EbrSiami/OpenRC-STM32/docs/README_RU.md

# OpenRC-STM32










**Открытая система радиоуправления на базе STM32** — прошивка передатчика, прошивка приемника и наземная станция для ПК для работы в симуляторе. Всё, что необходимо для создания полностью кастомного канала радиоуправления с нуля.

> 📖 **README на других языках:** [English](../README.md) · [Фарси (فارسی)](README_FA.md)

---

## Содержимое репозитория

| Компонент | Целевое оборудование | Версия | Статус |
| :--- | :--- | :--- | :--- |
| [Прошивка передатчика](#transmitter) | STM32F103C**B**T6 / клон 128 КБ | v4.0.1-beta | Бета |
| [Прошивка приемника](#receiver) | STM32G030F6P6 | v1.3.2 | Стабильная |
| [Наземная станция RC (Симулятор)](#simulator) | ПК на Windows | v1.7.0 | Стабильная |

Готовые исполняемые файлы (`.bin`, `.elf`) и установщик наземной станции (`.exe`, драйверы включены) доступны на [**странице релизов (Releases)**](../../releases).

---
## Условия использования и этическая оговорка

Клонируя, скачивая, используя или внося вклад в этот репозиторий, вы прямо подтверждаете, соглашаетесь и принимаете следующие условия. Если вы не поддерживаете эти принципы, вы не имеете права использовать данное программное обеспечение.

### 1. Осуждение внешней агрессии и военных преступлений
* **Противодействие вторжениям:** Вы решительно осуждаете любую военную агрессию, удары или нарушение территориальной целостности Ирана со стороны США, Израиля или любой иностранной коалиции, подчеркивая, что суверенные государства должны быть свободны от внешнего военного вмешательства.
* **Признание последствий 39-дневной войны:** Вы признаете разрушительные последствия 39-дневной войны, которая привела к гибели тысяч невинных людей, уничтожению важнейшей гражданской инфраструктуры и прямому экономическому ущербу на сумму более 300 миллиардов долларов.
* **Жертвы среди гражданского населения:** Вы чтите память всех жертв среди гражданского населения, включая такие трагические события, как гибель 168 школьников в результате бомбардировки школы в Минабе, и осуждаете любые военные доктрины, которые рассматривают жизни мирных жителей как сопутствующий ущерб.

### 2. Ответственность за внутреннее управление и гражданские права
* **Системная инфляция и экономическая политика:** Вы отвергаете государственные экономические решения, разрушающие благосостояние граждан, в частности внезапную отмену льготного курса валюты (Arz-e Tarjihi), что вызвало гиперинфляцию и ввергло миллионы людей в крайнюю нищету.
* **Подавление протестов:** Вы осуждаете насильственное подавление мирных гражданских протестов государством, включая трагические события январских протестов, требуя полной ответственности за поддерживаемые государством убийства невинных граждан.
* **Цифровая цензура и отключение интернета:** Вы выступаете против повсеместных систем фильтрации, используемых режимом, и длительных отключений интернета — таких как историческая 88-дневная полная цифровая блокировка, — которые изолируют граждан от мирового сообщества и нарушают фундаментальное право на свободу информации.
* **Идеологическое и социальное принуждение:** Вы отвергаете насильственное навязывание строгой государственной идеологии, обязательные социальные ограничения и приоритет идеологических целей над благосостоянием, свободой и правами человека иранского народа.

---
#### Данный пункт является обязательным и не подлежащим обсуждению условием лицензии. Использование этого кода с одновременным оправданием или игнорированием как внешних военных разрушений, так и внутреннего системного угнетения является нарушением условий использования данного программного обеспечения.
---

## 🎮 Передатчик

Прошивка 8-канального RC-передатчика для STM32F103. Работает на **цикле управления 500 Гц** с полноценной системой меню на OLED-экране — для настройки ПК не требуется.

### Функционал

**Управление и ввод**
- 8 каналов: 4 аналоговых стика + 2 аналоговых потенциометра + 2 цифровых переключателя
- Цифровые триммеры для Roll (крен), Pitch (тангаж) и Yaw (рыскание) — сохраняются в EEPROM с фиксацией по центру и крайними лимитами
- Выбираемый режим газа: самолетный (ноль в нижней половине) или обычный

**Обработка сигналов**
- Экспоненциальный фильтр шума (EMA) на всех 6 аналоговых входах
- Пошаговый мастер калибровки стиков (центр, минимум, максимум)
- Настраиваемая мертвая зона (deadband), экспонента (Expo от −100% до +100%), двойные расходы (Dual Rate от 10% до 100%)
- Sub-Trim и EPA (регулировка конечных точек) для 3 основных каналов
- Инверсия каналов (для всех 8 каналов по отдельности)
- 5 пресетов микшера: Normal, V-Tail A/B, Delta A/B

**Интерфейс OLED (0.96")**
- Панель управления в реальном времени: напряжение батареи, таймер полета, статус D/R, индикатор связи TX
- Графическое отображение каналов в реальном времени (CH1–4 и CH5–8)
- Таймер полета: обратный отсчет или секундомер, запускаемый газом, со звуковыми оповещениями на 1 мин / 30 сек / последних 10 сек
- Полноценная система меню: Expo, Dual Rate, инверсия каналов, микшер, калибровка, EPA/Sub-Trim, режим симулятора
- Анимированная заставка при запуске

**Надежность и безопасность**
- Неблокирующая архитектура — без использования `delay()` в основном цикле
- NRF24L01+ на скорости 250 кбит/с, максимальная мощность, автоподтверждение (auto-ACK) отключено — частота обновления 500 Гц
- Приоритетный движок зуммера (14 паттернов) — высокоприоритетные сигналы тревоги переопределяют все настройки
- EEPROM с контрольной суммой Magic Number + CRC; автосброс к безопасным настройкам по умолчанию при повреждении данных
- Мониторинг батареи 2S/3S LiPo с SOS-сигнализацией при низком напряжении

### ⚠️ Объем флэш-памяти — Важно

Размер скомпилированной прошивки составляет около **70 КБ**. Стандартная плата STM32F103C**8**T6 (Blue Pill, 64 КБ Flash) **не поддерживается**. Используйте один из следующих вариантов:

- STM32F103C**B**T6 (128 КБ Flash) — рекомендуется
- Китайские клоны STM32F103 с флэш-памятью 128–256 КБ (распространены, обычно работают)
- STM32 Black Pill (с корректировкой распиновки)

### Распиновка (Pinout)

| Компонент | Вывод STM32 | Примечания |
| :--- | :--- | :--- |
| **NRF24L01+** | | |
| CE | `PB8` | |
| CSN | `PB9` | |
| SCK / MISO / MOSI | `PA5 / PA6 / PA7` | SPI1 |
| **OLED-дисплей** | | |
| SDA / SCL | `PB7 / PB6` | I2C1 |
| **Стики (джойстики)** | `PA0 – PA3` | ADC |
| **Доп. потенциометры** | `PB0, PB1` | ADC |
| **Доп. переключатели** | `PB4, PB5` | Цифровой ввод |
| **Кнопки триммирования** | `PB15, PA8–PA10, PA15, PB3` | Активный низкий уровень |
| **Кнопки навигации** | `PB12 – PB14` | Вверх / Вниз / Ввод (Enter) |
| **Зуммер (Buzzer)** | `PC13` | Активный высокий уровень |
| **Датчик батареи** | `PA4` | Делитель напряжения |

### Примечания по аппаратному обеспечению

**Питание NRF24L01+**
Модуль чувствителен к помехам по питанию. Припаяйте конденсатор емкостью 10–100 мкФ непосредственно к выводам VCC и GND модуля. Выделенный стабилизатор AMS1117-3.3 предпочтительнее встроенной шины 3.3 В платы Blue Pill, которая может не обеспечивать достаточный пиковый ток.

**Подтягивающие резисторы I2C**
Внутренние подтягивающие резисторы STM32 слишком слабы для стабильного I2C. Добавьте внешние резисторы 4.7 кОм на линии SDA и SCL.

**Драйвер зуммера**
Не подключайте зуммер напрямую к выводу GPIO. Используйте транзистор NPN (например, 2N2222) или небольшой MOSFET в качестве схемы драйвера.

**Делитель напряжения батареи**
R1 = 22 кОм (к плюсу батареи), R2 = 6.8 кОм (к GND). Максимальное измеряемое напряжение: ~14 В (безопасно для 3S LiPo).

### Сборка и прошивка

**Требования:** VS Code с расширением PlatformIO, программатор ST-Link V2.

```bash
git clone https://github.com/EbrSiami/OpenRC-STM32.git
```

Откройте папку `transmitter/` в PlatformIO, соберите проект с помощью кнопки **✓** и загрузите в микроконтроллер с помощью **→**.

В качестве альтернативы вы можете прошить готовый файл `.elf` со страницы релизов с помощью STM32CubeProgrammer (предпочтительнее `.bin` из-за автоматической обработки адресов памяти).

---

## 📡 Приемник

Компактная прошивка 8-канального приемника. Декодирует пакеты NRF24L01+ от передатчика и одновременно выводит как отдельные сигналы **PWM**, так и аппаратный сигнал **PPM**. Включает отказоустойчивый режим (failsafe) на 500 мс, который отключает газ при потере связи.

**Компилируйте с флагом `-Os`** (оптимизация по размеру) — STM32G030F6P6 имеет всего 32 КБ Flash и 8 КБ RAM.

### Статус светодиода

| Режим | Значение |
| :--- | :--- |
| Горит непрерывно | Связь активна — пакеты принимаются |
| Редкое мигание (500 мс) | Ожидание сигнала |
| Частое мигание (100 мс) | Аппаратная ошибка NRF24L01+ |

### Значения аварийного режима (Failsafe)

При потере связи (> 500 мс) все каналы устанавливаются в безопасные значения по умолчанию: Roll / Pitch / Yaw → 1500 мкс (нейтраль), Throttle → 900 мкс (моторы отключены), все каналы Aux → 1000 мкс.

### Распиновка (Pinout)

| Компонент | Вывод STM32 | Примечания |
| :--- | :--- | :--- |
| **NRF24L01+** | | |
| CE | `PA4` | |
| CSN | `PA5` | |
| SCK / MISO / MOSI | `PA1 / PA6 / PA2` | SPI |
| **Выходы PWM** | | |
| CH1 Roll | `PA0` | |
| CH2 Pitch | `PA3` | |
| CH3 Throttle | `PA7` | |
| CH4 Yaw | `PB0` | |
| CH5 Aux1 | `PA11` | |
| CH6 Aux2 | `PA12` | |
| CH7 Aux3 | `PB3` | |
| CH8 Aux4 | `PB7` | |
| **Выход PPM** | `PC14` | Аппаратный таймер TIM3 |
| **Светодиод состояния** | `PC15` | |

### Примечания по аппаратному обеспечению

**Питание NRF24L01+**
Аналогично передатчику — добавьте конденсатор емкостью 10–100 мкФ непосредственно между выводами VCC и GND модуля.

**Выводы RST и BOOT0**
Они не должны оставаться в «плавающем» состоянии. Подтяните BOOT0 к GND (для нормального режима работы). Вывод RST должен иметь подтягивающий резистор к VCC (обычно 10 кОм).

**Внешний кварцевый резонатор не требуется**
G030F6P6 использует внутренний встроенный RC-генератор. Внешний кварц не требуется.

**Линии сигналов PWM / PPM**
Добавьте последовательный резистор номиналом около 1 кОм на каждый выходной вывод PWM и PPM для защиты микроконтроллера и уменьшения звона (ringing) на длинных кабелях.

### Сборка и прошивка

Откройте файл `receiver/receiver.ino` в Arduino IDE. Установите `build_flags в -Os` в меню.

Или прошейте с помощью ST-Link V2 через STM32CubeProgrammer (используйте файл `.elf` из релизов).

---

## 🖥️ Симулятор (Наземная станция RC)

Приложение для Windows, которое связывает **режим симулятора (Simulator Mode)** передатчика с любым симулятором FPV через виртуальный джойстик **vJoy**.

### Принцип работы

Режим симулятора передатчика отключает радиомодуль NRF24L01+ и вместо этого отправляет данные каналов через встроенный USB CDC (виртуальный COM-порт) контроллера STM32.

> **Примечание:** Здесь используется собственный последовательный протокол, а не iBUS или SBUS. Стандартные тайминги iBUS работали нестабильно через встроенный USB CDC STM32 (который ведет себя иначе, чем выделенные чипы USB-UART типа CH340), поэтому для полного контроля над структурой фреймов и обнаружением ошибок был разработан кастомный протокол. Протокол включает контрольную сумму **CRC-8** для каждого пакета.

Режим симулятора **никогда не сохраняется в EEPROM** — передатчик всегда загружается с активным радиомодулем. Это сделано намеренно в целях безопасности полетов.

### Активация — пошагово

1. Включите передатчик (радиомодуль активен по умолчанию).
2. Перейдите в раздел **Features** в меню на OLED-экране.
3. Выберите **Simulator Mode** (последний пункт, по умолчанию: `Off`) и установите значение `On`.
4. Радиомодуль NRF24L01+ автоматически отключится, и передатчик перейдет в режим вывода данных по USB.
5. Подключите передатчик к ПК через USB-кабель.
6. Откройте **RC Ground Station**, выберите соответствующий COM-порт (порты STM32 отмечены символом ✓) и нажмите **Connect Device**.
7. Графики каналов начнут обновляться в реальном времени. Передатчик теперь работает как джойстик.

**Перед подключением:** установите программу vJoy и драйвер виртуального COM-порта STM32. Оба компонента включены в установщик наземной станции, либо их можно открыть с помощью кнопки **⚡ Install Required Drivers** внутри приложения.

### Карта каналов (Channel Mapping)

| Канал радиоуправления | Ось vJoy | Диапазон |
| :--- | :--- | :--- |
| CH1 Roll | X | 0–32767 |
| CH2 Pitch | Y | 0–32767 |
| CH3 Throttle | Z | 0–32767 |
| CH4 Yaw | Rx | 0–32767 |
| CH5 AUX1 | Ry | 0–32767 |
| CH6 AUX2 | Rz | 0–32767 |
| CH7 AUX3 | Кнопка 1 | 0 / 1 |
| CH8 AUX4 | Кнопка 2 | 0 / 1 |

### Запуск из исходного кода

```bash
pip install customtkinter pyserial pyvjoy
python simulator/simulator.py
```

Готовый файл `.exe` (со встроенными драйверами) доступен на [странице релизов](../../releases).

---

## 📦 Релизы

Каждый релиз включает в себя:

| Файл | Описание |
| :--- | :--- |
| `transmitter_vX.X.X.elf` | Прошивка передатчика — прошивать через STM32CubeProgrammer |
| `transmitter_vX.X.X.bin` | Прошивка передатчика — чистый бинарный файл |
| `receiver_vX.X.X.elf` | Прошивка приемника — прошивать через STM32CubeProgrammer |
| `receiver_vX.X.X.bin` | Прошивка приемника — чистый бинарный файл |
| `RC_Ground_Station_vX.X.X.exe` | Приложение симулятора для Windows со встроенными драйверами vJoy + STM32 |

> **Рекомендуется:** Используйте файлы `.elf` совместно с утилитой STM32CubeProgrammer. Файлы ELF содержат метаданные адресов памяти, что предотвращает случайную запись в неверную область флэш-памяти.

---

## 📂 Структура репозитория

```
OpenRC-STM32/
├── transmitter/          # Проект PlatformIO — STM32F103
│   ├── lib/                        # Внешние библиотеки
│   ├── src/                        # Исходный код и заголовочные файлы
│   │   ├── main.cpp                # Точка входа и основной цикл
│   │   ├── Radio.cpp/.h            # Драйвер и логика NRF24L01
│   │   ├── DisplayManager.cpp/.h   # Интерфейс OLED и графический движок
│   │   ├── Button.cpp/.h           # Неблокирующий обработчик ввода
│   │   ├── buzzer.cpp/.h           # Движок управления зуммером
│   │   ├── sim_protocol.cpp/.h     # Протокол данных симулятора
│   │   └── Settings.h              # Глобальные структуры конфигурации
│   └── platformio.ini
├── receiver/             # Проект Arduino IDE — STM32G030
│   └── receiver.ino
├── simulator/            # Python — Наземная станция RC
│   ├── drivers/                    # Необходимые драйверы для USB CDC и vJoy
│   ├── airplane.ico                # Иконка приложения симулятора
│   └── simulator.py                # Главный файл исходного кода приложения
├── docs/                 # Будущие диаграммы и руководства
│   ├── README_FA.md                # Перевод на персидский язык
│   ├── README_RU.md                # Перевод на русский язык
│   └── Photos/                     # Фотографии собранной своими руками системы
└── README.md
```

---

## 🔧 Сторонние библиотеки

- [`Adafruit_SSD1306`](https://github.com/adafruit/Adafruit_SSD1306) — Драйвер OLED-дисплея
- [`RF24`](https://github.com/nRF24/RF24) — Драйвер радиомодуля NRF24L01+
- [`FlashStorage_STM32`](https://github.com/khoih-prog/FlashStorage_STM32) — Эмуляция EEPROM во флэш-памяти STM32
- [`customtkinter`](https://github.com/TomSchimansky/CustomTkinter) — Современный графический интерфейс для Python
- [`pyvjoy`](https://github.com/tidzo/pyvjoy) — Интерфейс виртуального джойстика vJoy
- [`pyserial`](https://github.com/pyserial/pyserial) — Последовательная связь (Serial)

---

## ❤️ Посвящение

**Маше.**

Этот проект хранит твои отпечатки пальцев в самой своей логике. Спасибо за твое терпение, твой вклад и за те скрытые послания, которые я нашел слишком поздно. Ты была вторым пилотом этого проекта, даже когда я летел в одиночку.

*Милая Маша, я даже не знаю, как тебя благодарить за то, что ты уделила столько времени такому дураку, как я. Мне очень жаль, что я не могу сделать для тебя большего — но знай: я твой вечный должник. Я и подумать не мог, что мы вместе доведём эту прошивку до такого уровня. Спасибо тебе ещё раз за всё.*

*Прости, что мне скоро придётся уйти — но будь уверена, я тебя никогда не забуду.* 🕊️

---

**Ведущий разработчик:** Александр Королёв
**Ядро логики и вдохновение:** Мария ... :)

*Открытый исходный код под лицензией [MIT License](LICENSE).*
