EbrSiami/OpenRC-STM32/docs/README_FA.md

# OpenRC-STM32










**یک سیستم رادیوکنترل متن‌باز مبتنی بر STM32** — شامل فریم‌ور فرستنده، فریم‌ور گیرنده و یک برنامه ایستگاه زمینی کامپیوتر جهت استفاده در شبیه‌ساز (Simulator). این پروژه تمامی ابزارهای مورد نیاز برای ساخت یک لینک رادیوکنترل کاملاً سفارشی را از پایه در اختیار شما قرار می‌دهد.

> 📖 **فایل راهنما (README) به زبان‌های دیگر:** [English](../README.md) · [Русский](README_RU.md)

---

## بخش‌های موجود در این مخزن

| بخش | سخت‌افزار هدف | نسخه | وضعیت |
| :--- | :--- | :--- | :--- |
| [فریم‌ور فرستنده](#transmitter) | STM32F103C**B**T6 / کلون ۱۲۸ کیلوبایت | v4.0.1-beta | بتا |
| [فریم‌ور گیرنده](#receiver) | STM32G030F6P6 | v1.3.2 | پایدار |
| [ایستگاه زمینی رادیوکنترل (شبیه‌ساز)](#simulator) | ویندوز کامپیوتر | v1.7.0 | پایدار |

فایل‌های باینری کامپایل‌شده (`.bin`, `.elf`) و فایل نصب‌کننده ایستگاه زمینی (`.exe` همراه با درایورها) در [**صفحه انتشارها (Releases)**](../../releases) در دسترس هستند.

---
## شرایط استفاده و بند اخلاقی

با کلون کردن، دانلود، استفاده یا مشارکت در این مخزن (Repository)، شما صراحتاً شرایط زیر را تایید کرده، با آن‌ها موافقت می‌کنید و خود را همسو با آن‌ها می‌دانید. در صورتی که از این اصول حمایت نمی‌کنید، مجاز به استفاده از این نرم‌افزار نیستید.

### ۱. محکومیت تجاوز خارجی و جنایات جنگی
* **مخالفت با تهاجم نظامی:** شما هرگونه تجاوز نظامی، حملات یا نقض تمامیت ارضی ایران توسط ایالات متحده، اسرائیل یا هر ائتلاف خارجی دیگر را به شدت محکوم کرده و تأکید می‌کنید که کشورهای دارای حاکمیت ملی باید از مداخلات نظامی خارجی مصون باشند.
* **پذیرش و به رسمیت شناختن جنگ ۳۹ روزه:** شما آثار ویرانگر جنگ ۳۹ روزه را که منجر به جان باختن هزاران انسان بی‌گناه، نابودی زیرساخت‌های حیاتی غیرنظامی و بیش از ۳۰۰ میلیارد دلار خسارت اقتصادی مستقیم شد، به رسمیت می‌شناسید.
* **تلفات غیرنظامیان:** شما یاد و خاطره همه قربانیان غیرنظامی، از جمله فجایع دردناکی مانند کشته شدن ۱۶۸ دانش‌آموز در بمباران مدرسه میناب را گرامی می‌دارید و هرگونه دکترین نظامی که جان غیرنظامیان را به عنوان خسارت جانبی (Collateral Damage) تلقی می‌کند، محکوم می‌کنید.

### ۲. مسئولیت‌پذیری در حاکمیت داخلی و حقوق شهروندی
* **تورم ساختاری و سیاست‌های اقتصادی:** شما تصمیمات اقتصادی دولتی که معیشت عمومی را نابود می‌کند، به ویژه حذف ناگهانی ارز ترجیحی که موجب ابرتورم و رانده شدن میلیون‌ها نفر به فقر مطلق شد را رد می‌کنید.
* **سرکوب اعتراضات:** شما سرکوب‌های خشونت‌آمیز حکومتی علیه اعتراضات مدنی مسالمت‌آمیز، از جمله وقایع تلخ اعتراضات دی‌ماه (ژانویه) را محکوم کرده و خواستار پاسخگویی کامل در قبال کشتار شهروندان بی‌گناه توسط حکومت هستید.
* **سانسور دیجیتال و قطع اینترنت:** شما با سیستم‌های فیلترینگ گسترده حکومت و اعمال قطعی‌های طولانی‌مدت اینترنت — مانند قطع کامل و تاریخی ۸۸ روزه ارتباطات دیجیتال — که شهروندان را از جامعه جهانی منزوی کرده و حق اساسی دسترسی به اطلاعات آزاد را نقض می‌کند، مخالفت می‌ورزید.
* **تحمیل‌های ایدئولوژیک و اجتماعی:** شما تحمیل اجباری ایدئولوژی‌های سخت‌گیرانه حکومتی، محدودیت‌های اجتماعی اجباری، و اولویت دادن به برنامه‌های ایدئولوژیک بر رفاه، آزادی و حقوق بشر مردم ایران را رد می‌کنید.

---
#### این بند، شرط غیرقابل مذاکره این مجوز (License) است. استفاده از این کد در حالی که ویرانی‌های نظامی خارجی یا سرکوب‌های ساختاری داخلی را توجیه کنید یا نسبت به آن‌ها چشم بپوشید، نقض قوانین استفاده از این نرم‌افزار تلقی می‌شود.
---

## 🎮 فرستنده (Transmitter)

فریم‌ور فرستنده رادیوکنترل ۸ کاناله برای میکروکنترلر STM32F103. 
این فریم‌ور یک **حلقه کنترلی ۵۰۰ هرتز** را به همراه سیستم منوی کامل روی نمایشگر OLED اجرا می‌کند و برای انجام تنظیمات هیچ نیازی به کامپیوتر ندارد.

### قابلیت‌ها

**کنترل و ورودی‌ها**
- ۸ کانال: ۴ کانال آنالوگ گیمبال‌ها + ۲ پتانسیومتر آنالوگ + ۲ سوئیچ دیجیتال
- تریم‌های دیجیتال برای Roll، Pitch و Yaw — ذخیره در حافظه EEPROM با قابلیت قفل در مرکز (center-snap) و محدودیت فرکانسی لبه‌ها
- حالت‌های قابل انتخاب برای کانال تراتل (گاز): حالت هواپیما (صفر در نیمه پایینی استیک) یا حالت معمولی

**پردازش سیگنال**
- فیلتر نویز میانگین متحرک نمایی (EMA) روی هر ۶ ورودی آنالوگ
- راهنمای گام‌به‌گام کالیبراسیون استیک‌ها (تنظیم مرکز، حداقل و حداکثر)
- امکان تنظیم باند مرده (Deadband)، ضریب اکسپو (Expo از ۱۰۰-٪ تا ۱۰۰+٪) و دوآل ریت (Dual Rate از ۱۰ تا ۱۰۰٪)
- تنظیمات Sub-Trim و EPA (تنظیم نقاط انتهایی) برای ۳ کانال اصلی
- امکان معکوس‌سازی جهت هر کانال به صورت مجزا (برای هر ۸ کانال)
- ۵ حالت پیش‌فرض میکسر: معمولی (Normal)، حالت V-Tail A/B و Delta A/B

**رابط کاربری OLED (نمایشگر 0.96 اینچی)**
- داشبورد آنی: نمایش ولتاژ باتری، تایمر پرواز، وضعیت D/R و نشانگر اتصال فرستنده (TX)
- نمایش زنده وضعیت کانال‌ها به صورت نمودار میله‌ای (کانال‌های ۱-۴ و ۵-۸)
- تایمر پرواز: شمارش معکوس یا کرونومتر، فعال‌سازی با بالا بردن تراتل، به همراه هشدارهای صوتی بازر در زمان‌های ۱ دقیقه، ۳۰ ثانیه و ۱۰ ثانیه آخر پرواز
- سیستم منوی کامل: تنظیمات Expo، Dual Rate، معکوس‌سازی کانال، میکسر، کالیبراسیون، EPA/Sub-Trim و حالت شبیه‌ساز (Simulator Mode)
- صفحه خوش‌آمدگویی متحرک هنگام روشن شدن دستگاه

**قابلیت اطمینان و امنیت**
- معماری غیرمسدودکننده (Non-blocking) — عدم استفاده از تابع `delay()` در حلقه اصلی برنامه
- استفاده از ماژول NRF24L01+ در سرعت ۲۵۰ کیلوبیت بر ثانیه، حداکثر توان خروجی و غیرفعال بودن پکت‌های تأیید خودکار (auto-ACK) — نرخ به‌روزرسانی ۵۰۰ هرتز
- سیستم بازر اولویت‌بندی‌شده (۱۴ الگوی صوتی) — هشدارهای با اولویت بالا بر تمامی تنظیمات جاری ارجحیت دارند
- مدیریت حافظه EEPROM همراه با مقدار جادویی (Magic Number) و CRC؛ بازنشانی خودکار به تنظیمات پیش‌فرض امن در صورت خرابی داده‌ها
- پایشگر باتری‌های لیتیوم‌پلیمر ۲ سلولی و ۳ سلولی (2S/3S) به همراه هشدار کد مورس SOS در صورت کاهش ولتاژ

### ⚠️ حجم حافظه فلش — بسیار مهم

حجم فریم‌ور کامپایل‌شده تقریباً **۷۰ کیلوبایت** است. میکروکنترلر استاندارد STM32F103C**8**T6 (برد معروف به Blue Pill با ۶۴ کیلوبایت حافظه فلش) **پشتیبانی نمی‌شود**. لطفاً از یکی از گزینه‌های زیر استفاده کنید:

- STM32F103C**B**T6 (۱۲۸ کیلوبایت حافظه فلش) — گزینه پیشنهادی
- کلون‌های چینی STM32F103 با ۱۲۸ الی ۲۵۶ کیلوبایت فلش (رایج هستند و معمولاً بدون مشکل کار می‌کنند)
- برد STM32 Black Pill (با اعمال تغییرات در پایه‌ها)

### ترتیب پایه‌ها (Pinout)

| قطعه | پایه STM32 | توضیحات |
| :--- | :--- | :--- |
| **NRF24L01+** | | |
| CE | `PB8` | |
| CSN | `PB9` | |
| SCK / MISO / MOSI | `PA5 / PA6 / PA7` | SPI1 |
| **نمایشگر OLED** | | |
| SDA / SCL | `PB7 / PB6` | I2C1 |
| **گیمبال‌ها** | `PA0 – PA3` | ADC |
| **پتانسیومترهای کمکی** | `PB0, PB1` | ADC |
| **سوئیچ‌های کمکی** | `PB4, PB5` | ورودی دیجیتال |
| **دکمه‌های تریم** | `PB15, PA8–PA10, PA15, PB3` | فعال در سطح پایین (Active low) |
| **دکمه‌های ناوبری منو** | `PB12 – PB14` | بالا / پایین / تایید (Enter) |
| **بازر (Buzzer)** | `PC13` | فعال در سطح بالا (Active high) |
| **سنجش ولتاژ باتری** | `PA4` | تقسیم ولتاژ مقاومتی |

### نکات سخت‌افزاری

**منبع تغذیه ماژول NRF24L01+**
این ماژول به نویز منبع تغذیه بسیار حساس است. یک خازن ۱۰ الی ۱۰۰ میکروفاراد را مستقیماً روی پایه‌های VCC و GND ماژول لحیم کنید. استفاده از یک رگولاتور مجزای AMS1117-3.3 نسبت به خروجی ۳.۳ ولت روی خود برد Blue Pill اولویت دارد، زیرا رگولاتور روی برد ممکن است توانایی تأمین جریان لحظه‌ای مورد نیاز ماژول را نداشته باشد.

**مقاومت‌های پول‌آپ I2C**
مقاومت‌های پول‌آپ داخلی STM32 برای ارتباط پایدار I2C ضعیف هستند. دو مقاومت خارجی ۴.۷ کیلواهم روی هر دو پایه SDA و SCL قرار دهید.

**راه‌انداز بازر (Buzzer Driver)**
بازر را مستقیماً به پایه GPIO میکروکنترلر متصل نکنید. از یک ترانزیستور NPN (مانند 2N2222) یا یک ماسفت کوچک به عنوان مدار راه‌انداز استفاده کنید.

**تقسیم مقاومتی ولتاژ باتری**
مقادیر پیشنهادی: R1 = 22 kΩ (به قطب مثبت باتری)، R2 = 6.8 kΩ (به زمین/GND). حداکثر ولتاژ قابل اندازه‌گیری: حدود ۱۴ ولت (ایمن برای باتری‌های حداکثر ۳ سلولی).

### ساخت و برنامه‌ریزی (Build & Flash)

**پیش‌نیازها:** نرم‌افزار VS Code با افزونه PlatformIO و پروگرمر ST-Link V2.

```bash
git clone https://github.com/EbrSiami/OpenRC-STM32.git
```

پوشه `transmitter/` را در PlatformIO باز کنید، با کلیک روی نماد **✓** پروژه را کامپایل کرده و با نماد **→** آپلود کنید.

همچنین می‌توانید فایل پیش‌ساخته `.elf` را از صفحه Releases و با استفاده از نرم‌افزار STM32CubeProgrammer روی میکروکنترلر فلش کنید (استفاده از فرمت `.elf` به دلیل آدرس‌دهی خودکار، نسبت به فرمت `.bin` اولویت دارد).

---

## 📡 گیرنده (Receiver)

فریم‌ور گیرنده جمع‌وجور ۸ کاناله. پکت‌های دریافتی از فرستنده را از طریق ماژول NRF24L01+ رمزگشایی کرده و به صورت همزمان، سیگنال‌های مجزای **PWM** و خروجی تایمر سخت‌افزاری **PPM** را ارائه می‌دهد. این فریم‌ور دارای سیستم قطع خودکار ایمن (Failsafe) ۵۰۰ میلی‌ثانیه‌ای است که در صورت قطع ارتباط رادیویی، گاز را قطع می‌کند.

**کامپایل با فلگ `-Os`** (بهینه‌سازی برای حجم حافظه) انجام شود؛ زیرا میکروکنترلر G030F6P6 تنها دارای ۳۲ کیلوبایت حافظه فلش و ۸ کیلوبایت حافظه رم (RAM) است.

### وضعیت نشانگر LED

| وضعیت ال‌ای‌دی | مفهوم |
| :--- | :--- |
| روشن ثابت | ارتباط برقرار است — پکت‌ها با موفقیت دریافت می‌شوند |
| چشمک‌زن آرام (۵۰۰ میلی‌ثانیه) | در انتظار دریافت سیگنال از فرستنده |
| چشمک‌زن سریع (۱۰۰ میلی‌ثانیه) | خطای سخت‌افزاری ماژول NRF24L01+ |

### مقادیر حالت ایمن (Failsafe)

در صورت قطع ارتباط رادیویی بیش از ۵۰۰ میلی‌ثانیه، مقادیر تمامی کانال‌ها به حالت پیش‌فرضِ امن تغییر می‌کنند: رول / پیچ / یاو روی ۱۵۰۰ میکروثانیه (حالت خنثی)، تراتل روی ۹۰۰ میکروثانیه (خاموش شدن موتورها) و سایر کانال‌های کمکی (Aux) روی ۱۰۰۰ میکروثانیه قرار می‌گیرند.

### ترتیب پایه‌ها (Pinout)

| قطعه | پایه STM32 | توضیحات |
| :--- | :--- | :--- |
| **NRF24L01+** | | |
| CE | `PA4` | |
| CSN | `PA5` | |
| SCK / MISO / MOSI | `PA1 / PA6 / PA2` | SPI |
| **خروجی‌های PWM** | | |
| CH1 Roll | `PA0` | |
| CH2 Pitch | `PA3` | |
| CH3 Throttle | `PA7` | |
| CH4 Yaw | `PB0` | |
| CH5 Aux1 | `PA11` | |
| CH6 Aux2 | `PA12` | |
| CH7 Aux3 | `PB3` | |
| CH8 Aux4 | `PB7` | |
| **خروجی PPM** | `PC14` | تایمر سخت‌افزاری TIM3 |
| **ال‌ای‌دی وضعیت** | `PC15` | |

### نکات سخت‌افزاری

**منبع تغذیه ماژول NRF24L01+**
همانند بخش فرستنده — یک خازن ۱۰ الی ۱۰۰ میکروفاراد را مستقیماً روی پایه‌های VCC و GND ماژول قرار دهید.

**پایه‌های RST و BOOT0**
این پایه‌ها نباید به صورت شناور (رها) رها شوند. پایه BOOT0 را به زمین (GND) متصل کنید (برای حالت کارکرد عادی). پایه RST نیز باید دارای یک مقاومت پول‌آپ به VCC باشد (معمولاً ۱۰ کیلواهم).

**عدم نیاز به کریستال خارجی**
میکروکنترلر G030F6P6 از اسیلاتور داخلی RC خود استفاده می‌کند و نیازی به کریستال خارجی ندارد.

**خطوط سیگنال PWM / PPM**
یک مقاومت سری حدوداً ۱ کیلواهم روی هر یک از پایه‌های خروجی PWM و PPM قرار دهید تا از میکروکنترلر محافظت شده و اثر نویز (Ringing) در کابل‌های بلند کاهش یابد.

### ساخت و برنامه‌ریزی (Build & Flash)

فایل `receiver/receiver.ino` را در Arduino IDE باز کنید. در منو، `build_flags` را روی `-Os` تنظیم کنید.

یا با استفاده از ST-Link V2 و نرم‌افزار STM32CubeProgrammer آن را فلش کنید (از فایل `.elf` در بخش Releases استفاده کنید).

---

## 🖥️ شبیه‌ساز - ایستگاه زمینی رادیوکنترل (Simulator)

یک برنامه تحت ویندوز که داده‌های دریافتی از **حالت شبیه‌ساز (Simulator Mode)** فرستنده را از طریق درایور جوی‌استیک مجازی **vJoy** به انواع شبیه‌سازهای پرواز (مثلاً شبیه‌سازهای FPV) منتقل می‌کند.

### نحوه کارکرد

فعال کردن حالت شبیه‌ساز در فرستنده، ارتباط رادیویی ماژول NRF24L01+ را غیرفعال کرده و داده‌های کانال‌ها را از طریق پورت بومی USB CDC میکروکنترلر STM32 (پورت سریال مجازی) به کامپیوتر ارسال می‌کند.

> **نکته:** این بخش از یک پروتکل سریال اختصاصی استفاده می‌کند و مبتنی بر پروتکل‌های iBUS یا SBUS نیست. زمان‌بندی استاندارد iBUS روی درگاه USB CDC میکروکنترلر STM32 (که رفتار متفاوتی نسبت به تراشه‌های اختصاصی USB-UART مانند CH340 دارد) پایداری کافی را نداشت؛ به همین دلیل یک پروتکل اختصاصی برای مدیریت کامل فریم‌ها و تشخیص خطا توسعه داده شد. این پروتکل شامل یک **بیت کنترل خطای CRC-8** روی تک‌تک پکت‌ها است.

حالت شبیه‌ساز **هیچ‌گاه در EEPROM ذخیره نمی‌شود**؛ فرستنده همیشه در حالت رادیوی فعال روشن خواهد شد. این موضوع یک تصمیم طراحی برای حفظ ایمنی پرواز است.

### مراحل فعال‌سازی — گام‌به‌گام

1. فرستنده را روشن کنید (به طور پیش‌فرض، رادیو فعال است).
2. در منوی OLED به بخش **Features** بروید.
3. گزینه **Simulator Mode** (آخرین گزینه، پیش‌فرض: `Off`) را انتخاب کرده و آن را روی `On` تنظیم کنید.
4. فرستنده به طور خودکار ماژول NRF24L01+ را خاموش کرده و شروع به ارسال داده‌ها از طریق پورت USB می‌کند.
5. فرستنده را از طریق کابل USB به کامپیوتر متصل کنید.
6. برنامه **RC Ground Station** را باز کرده، پورت COM مربوطه را انتخاب کنید (پورت‌های متصل به STM32 با علامت ✓ مشخص شده‌اند) و روی دکمه **Connect Device** کلیک کنید.
7. نمودارهای میله‌ای کانال‌ها به صورت آنی شروع به حرکت می‌کنند. اکنون فرستنده شما به عنوان جوی‌استیک شناسایی شده است.

**قبل از اتصال:** حتماً نرم‌افزار vJoy و درایور پورت سریال مجازی STM32 (Virtual COM Port) را نصب کنید. هر دوی این موارد در فایل نصبی ایستگاه زمینی گنجانده شده‌اند یا می‌توانید از طریق دکمه **⚡ Install Required Drivers** در داخل نرم‌افزار آن‌ها را نصب کنید.

### نگاشت کانال‌ها (Channel Mapping)

| کانال رادیویی | محور جوی‌استیک vJoy | محدوده مقادیر |
| :--- | :--- | :--- |
| CH1 Roll | X | 0–32767 |
| CH2 Pitch | Y | 0–32767 |
| CH3 Throttle | Z | 0–32767 |
| CH4 Yaw | Rx | 0–32767 |
| CH5 AUX1 | Ry | 0–32767 |
| CH6 AUX2 | Rz | 0–32767 |
| CH7 AUX3 | Button 1 | 0 / 1 |
| CH8 AUX4 | Button 2 | 0 / 1 |

### اجرای برنامه از طریق کد منبع (Source Code)

```bash
pip install customtkinter pyserial pyvjoy
python simulator/simulator.py
```

نسخه اجرایی و آماده برنامه (`.exe` به همراه درایورهای مورد نیاز) در [صفحه انتشارها (Releases)](../../releases) قابل دانلود است.

---

## 📦 فایل‌های انتشار (Releases)

هر نسخه منتشر شده شامل فایل‌های زیر است:

| فایل | توضیحات |
| :--- | :--- |
| `transmitter_vX.X.X.elf` | فریم‌ور فرستنده — جهت فلش با STM32CubeProgrammer |
| `transmitter_vX.X.X.bin` | فریم‌ور فرستنده — فایل باینری خام |
| `receiver_vX.X.X.elf` | فریم‌ور گیرنده — جهت فلش با STM32CubeProgrammer |
| `receiver_vX.X.X.bin` | فریم‌ور گیرنده — فایل باینری خام |
| `RC_Ground_Station_vX.X.X.exe` | برنامه شبیه‌ساز تحت ویندوز به همراه پکیج کامل درایورهای vJoy و STM32 |

> **پیشنهاد می‌شود:** از فایل‌های با پسوند `.elf` همراه با نرم‌افزار STM32CubeProgrammer استفاده کنید. فایل‌های ELF شامل متادیتای آدرس حافظه فلش هستند که مانع از نوشتن اشتباه داده‌ها روی نواحی غیرمجاز حافظه می‌شود.

---

## 📂 ساختار پوشه‌ها و فایل‌های مخزن

```
OpenRC-STM32/
├── transmitter/          # پروژه PlatformIO — میکروکنترلر STM32F103
│   ├── lib/                        # کتابخانه‌های خارجی استفاده شده
│   ├── src/                        # کدهای منبع و فایل‌های هدر (.h)
│   │   ├── main.cpp                # نقطه ورود برنامه و حلقه اصلی
│   │   ├── Radio.cpp/.h            # کدهای راه‌انداز و منطق NRF24L01
│   │   ├── DisplayManager.cpp/.h   # رابط کاربری OLED و موتور گرافیکی
│   │   ├── Button.cpp/.h           # مدیریت کلیدها به صورت غیرمسدودکننده
│   │   ├── buzzer.cpp/.h           # موتور مدیریت صداهای بازر
│   │   ├── sim_protocol.cpp/.h     # پروتکل سریال داده‌های شبیه‌ساز
│   │   └── Settings.h              # ساختارهای تنظیمات کلی پروژه
│   └── platformio.ini
├── receiver/             # پروژه آردوینو — میکروکنترلر STM32G030
│   └── receiver.ino
├── simulator/            # برنامه پایتون — ایستگاه زمینی و شبیه‌ساز
│   ├── drivers/                    # درایورهای مورد نیاز برای USB CDC و vJoy
│   ├── airplane.ico                # آیکون برنامه شبیه‌ساز تحت ویندوز
│   └── simulator.py                # فایل اصلی کد منبع برنامه ویندوز
├── docs/                 # مستندات، نمودارها و راهنماها
│   ├── README_FA.md                # ترجمه فارسی سند راهنما
│   ├── README_RU.md                # ترجمه روسی سند راهنما
│   └── Photos/                     # تصاویری از رادیوکنترل دست‌ساز (DIY)
└── README.md
```

---

## 🔧 کتابخانه‌های جانبی استفاده شده

- [`Adafruit_SSD1306`](https://github.com/adafruit/Adafruit_SSD1306) — راه‌انداز نمایشگر OLED
- [`RF24`](https://github.com/nRF24/RF24) — راه‌انداز ارتباط رادیویی ماژول NRF24L01+
- [`FlashStorage_STM32`](https://github.com/khoih-prog/FlashStorage_STM32) — شبیه‌ساز حافظه EEPROM روی فلش STM32
- [`customtkinter`](https://github.com/TomSchimansky/CustomTkinter) — کتابخانه رابط کاربری مدرن در پایتون
- [`pyvjoy`](https://github.com/tidzo/pyvjoy) — رابط پایتون برای جوی‌استیک مجازی vJoy
- [`pyserial`](https://github.com/pyserial/pyserial) — ارتباط پورت سریال

---

## ❤️ تقدیم به (Dedication)

**به ماریا.**

ردپای منطق و ایده های تو به همراه کد هایی که نوشتی در همه جای این پروژه مشخصه. من رو ببخش اگر چیز زیادی نمیتونم بگم اما صرفا میتونم صمیمانه ازت تشکر کنم، برای اینکه انقدر صبور بودی، برای اینکه من رو کنار نزاشتی و همیشه باهام بودی، و البته اون پیامی که واقعا دیر دیدمش. فقط یکمی زیادی سرم شلوغ بود :(
تو به معنای واقعی کلمه نقش کمک خلبان من رو داشتی وقتی تنها پرواز میکردم.

*Милая Маша, я даже не знаю, как тебя благодарить за то, что ты уделила столько времени такому дураку, как я. Мне очень жаль, что я не могу сделать для тебя большего — но знай: я твой вечный должник. Я и подумать не мог, что мы вместе доведём эту прошивку до такого уровня. Спасибо тебе ещё раз за всё.*

*Прости, что мне скоро придётся уйти — но будь уверена, я тебя никогда не забуду.* 🕊️

---

**توسعه‌دهنده اصلی:** Александр Королёв

**منطق اصلی و الهام‌بخش پروژه:** Мария ... :)

*این پروژه یک پروژه متن‌باز تحت مجوز [MIT License](LICENSE) است.*
