EbrSiami/OpenRC-STM32/transmitter/src/Radio.h

/**
 * @file Radio.h
 * @author Александр Королёв
 * @brief NRF24L01+ Communication Driver
 * @version 4.0.1
 * @date 2026-04-24
 * 
 * Defines the NRF24L01+ configuration pins and the data packet structure
 * used for communication between the transmitter and receiver.
 * 
 * Fixing Data Packet Structure
 * 
 */

#ifndef RADIO_H
#define RADIO_H

#include <Arduino.h>
#include <RF24.h>

// --- Hardware Pin Configuration (STM32 BluePill) ---
#define RF_CE_PIN  PB8
#define RF_CSN_PIN PB9

/**
 * @brief Control Data Packet Structure
 * CRITICAL: This structure must match EXACTLY on the Receiver side.
 */
#pragma pack(push, 1)
typedef struct {
    uint16_t roll     : 11;
    uint16_t pitch    : 11;
    uint16_t throttle : 11;
    uint16_t yaw      : 11;
    uint8_t  aux1     : 8;
    uint8_t  aux2     : 8;
    uint8_t  aux3     : 1;
    uint8_t  aux4     : 1;
} data_t;
#pragma pack(pop)

// Global Radio Object (Defined in Radio.cpp)
extern RF24 radio;

// --- Function Prototypes ---

bool getRadioStatus(); 

/**
 * @brief Initializes the radio hardware and settings.
 */
void setupRadio();

/**
 * @brief Sends a single data packet.
 * @param dataToSend The populated data structure.
 */
void sendRadioData(data_t dataToSend);

/**
 * @brief use it to turn off the radio (like simulator mode)
 **/
void setRadioPower(bool enable);

#endif // RADIO_H
