EbrSiami/OpenRC-STM32/(commit log)

2026-05-13 fixes #2 implement inactivity timeout with edit mode protection
    [main.cpp]
2026-05-13 update ResetData() with 11bit data and fix old 8bit variable in PAGE_EXPO
    [DisplayManager.cpp, main.cpp]
2026-05-19 some bugfixes and code impoverments
    1- fixing EMA Filter. 2- update isthrottleactive() and handletimerlogic() for new 11bit throttle value. 3- update step 3 (expo) in processchannel() to be safer in zero values. 4- add pinmodes to decrease noises in system starting and etc. 5- update throttle logic in loop to fix some strange bugs!
    [main.cpp]
2026-06-25 chore: rebrand and restructure project as OpenRC-STM32
    - rename repository from STM32-RC-Transmitter to OpenRC-STM32
    - add receiver firmware (STM32G030F6P6) with full documentation
    - add RC Ground Station simulator (Python/vJoy)
    - rewrite README as unified doc covering all three components
    - add file headers and inline comments to receiver.cpp and simulator.py
    - document custom serial protocol, simulator activation flow, and release structure
